modern-hobbyist/drone-controller/Schematic_drone-controller_2022-11-30.pdf

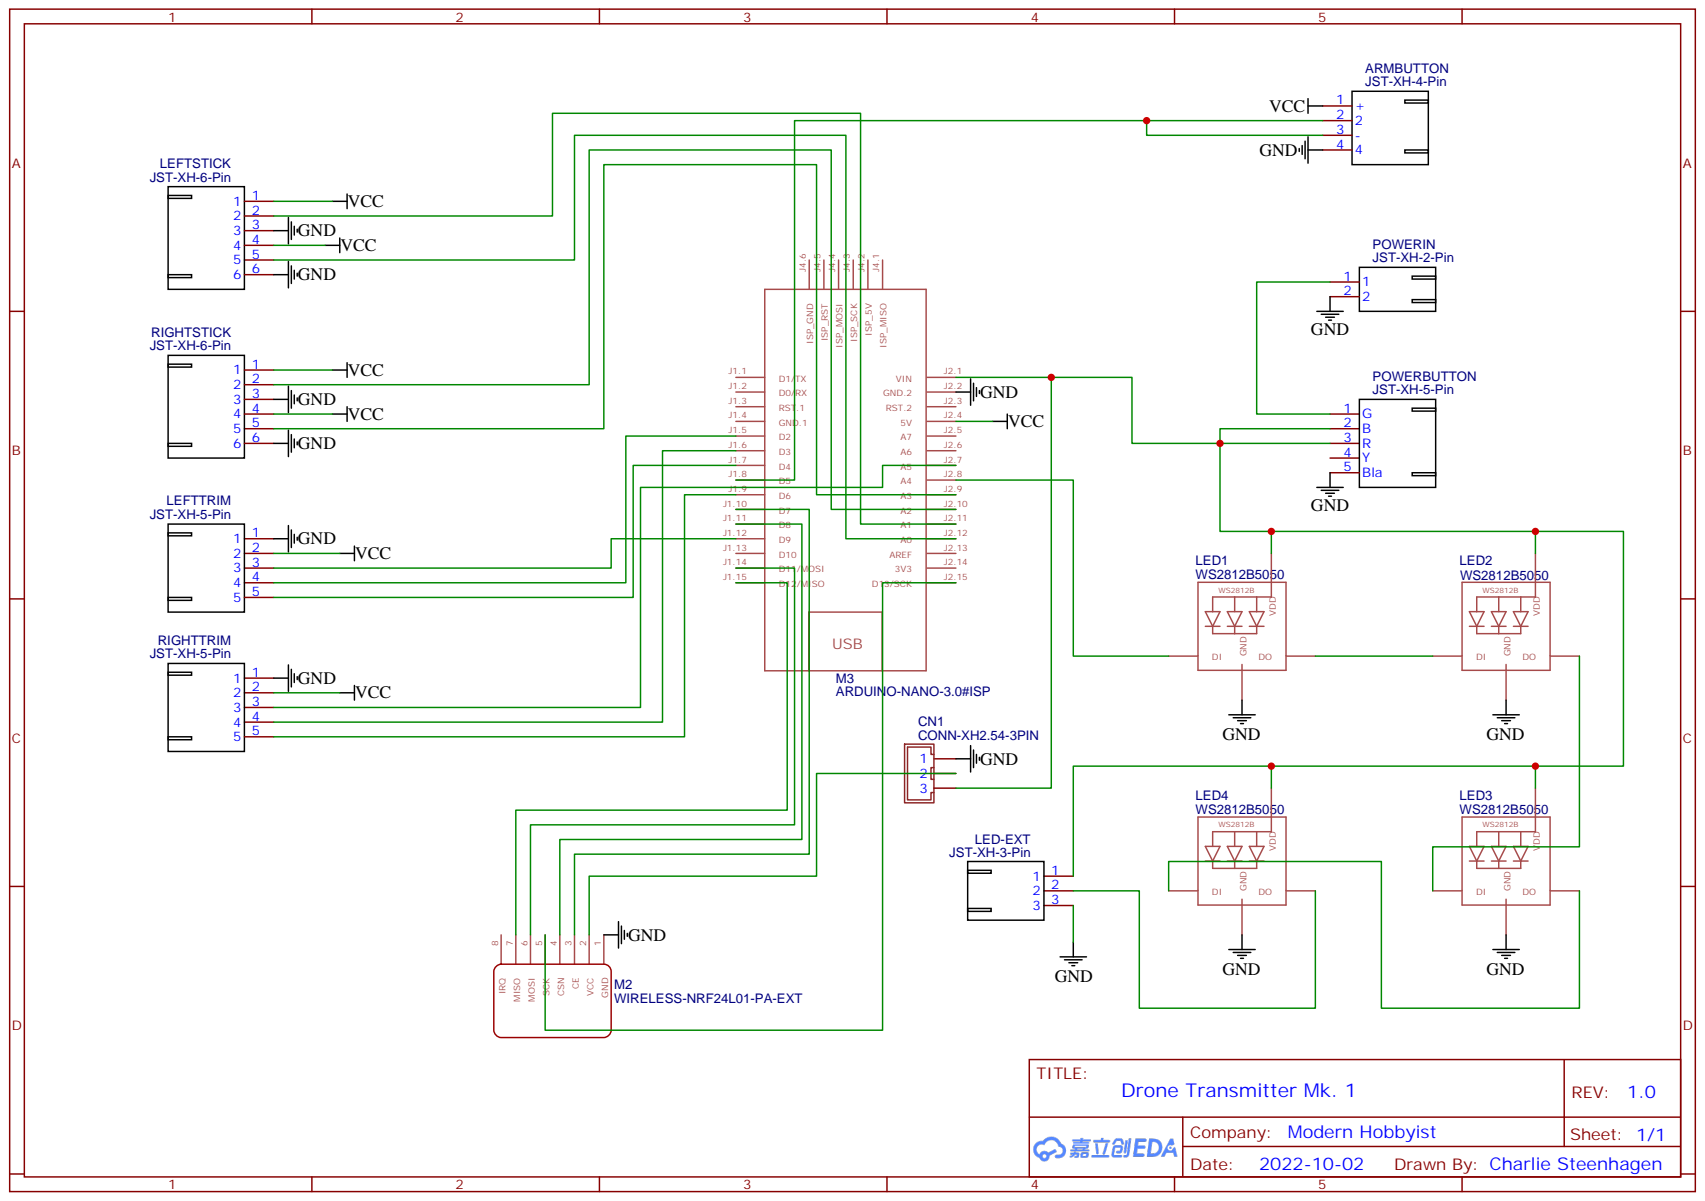
[picture p1: page 1]

Drawn By: Charlie Steenhagen
