modern-hobbyist/drone-controller/receiver/receiver.ino

#include <SPI.h>
#include <nRF24L01.h>
#include <RF24.h>

/*
 * PPM generator originally written by David Hasko
 * on https://code.google.com/p/generate-ppm-signal/ 
 */

//////////////////////CONFIGURATION///////////////////////////////
#define CHANNEL_NUMBER 6  //set the number of chanels
#define CHANNEL_DEFAULT_VALUE 1500  //set the default servo value
#define FRAME_LENGTH 22500  //set the PPM frame length in microseconds (1ms = 1000µs)
#define PULSE_LENGTH 300  //set the pulse length
#define onState 1  //set polarity of the pulses: 1 is positive, 0 is negative
#define sigPin 2  //set PPM signal output pin on the arduino

const byte address[6] = "00001";

RF24 radio(7, 8);

/*this array holds the servo values for the ppm signal
 change theese values in your code (usually servo values move between 1000 and 2000)*/
int ppm[CHANNEL_NUMBER];

// The sizeof this struct should not exceed 32 bytes
struct MyData {
  byte throttle;
  byte yaw;
  byte pitch;
  byte roll;
  byte AUX1;
  byte AUX2;
};

MyData data;
bool sendData = false;

void resetData() 
{
  // 'safe' values to use when no radio input is detected
  data.throttle = 0;
  data.yaw = 127;
  data.pitch = 127;
  data.roll = 127;
  data.AUX1 = 1;
  data.AUX2= 1;
  
  setPPMValuesFromData();
}

void setPPMValuesFromData()
{
  ppm[0] = map(data.roll,     0, 255, 1000, 2000);
  ppm[1] = map(data.pitch,    0, 255, 1000, 2000);
  ppm[2] = map(data.throttle, 0, 255, 1000, 2000);
  ppm[3] = map(data.yaw,      0, 255, 1000, 2000);
  ppm[4] = map(data.AUX1,     0, 1, 1000, 2000);
  ppm[5] = map(data.AUX2,     0, 1, 1000, 2000);  
  }

/**************************************************/

void setupPPM() {
  pinMode(sigPin, OUTPUT);
  digitalWrite(sigPin, 0);  //set the PPM signal pin to the default state (off)

  cli();
  TCCR1A = 0; // set entire TCCR1 register to 0
  TCCR1B = 0;

  OCR1A = 100;  // compare match register (not very important, sets the timeout for the first interrupt)
  TCCR1B |= (1 << WGM12);  // turn on CTC mode
  TCCR1B |= (1 << CS11);  // 8 prescaler: 0,5 microseconds at 16mhz
  TIMSK1 |= (1 << OCIE1A); // enable timer compare interrupt
  sei();
}

void setup(){  
  Serial.begin(115200);

  resetData();
  setupPPM();
  
  // Set up radio module
  radio.begin();
  radio.openReadingPipe(0, address);
  radio.setPALevel(RF24_PA_MIN);
  radio.startListening();
  
  //initiallize default ppm values
  for(int i=0; i<CHANNEL_NUMBER; i++){
      ppm[i]= CHANNEL_DEFAULT_VALUE;
  }

  pinMode(sigPin, OUTPUT);
  digitalWrite(sigPin, !onState);  //set the PPM signal pin to the default state (off)
  
  cli();
  TCCR1A = 0; // set entire TCCR1 register to 0
  TCCR1B = 0;
  
  OCR1A = 100;  // compare match register, change this
  TCCR1B |= (1 << WGM12);  // turn on CTC mode
  TCCR1B |= (1 << CS11);  // 8 prescaler: 0,5 microseconds at 16mhz
  TIMSK1 |= (1 << OCIE1A); // enable timer compare interrupt
  sei();

}

/**************************************************/

unsigned long lastRecvTime = 0;

void recvData()
{  
  while ( radio.available() ) {        
    radio.read(&data, sizeof(MyData));
    lastRecvTime = millis();
    sendData = true;
  }
}

/**************************************************/

void loop(){
  
  recvData();

  unsigned long now = millis();
  if ( now - lastRecvTime > 1000 ) {
    // signal lost?
    resetData();
    sendData = false;
  }
  
  setPPMValuesFromData();
  printValues();
  
}

void printValues(){
  // for(int i = 0; i < CHANNEL_NUMBER; i++){
  //   Serial.print(ppm[i]);
  //   Serial.print(" - ");  
  // }
  // Serial.println();
  // Serial.println(ppm[2]);
}

ISR(TIMER1_COMPA_vect){  //leave this alone
  static boolean state = true;
  
  TCNT1 = 0;
  if(sendData){
    if (state) {  //start pulse
      digitalWrite(sigPin, onState);
      OCR1A = PULSE_LENGTH * 2;
      state = false;
    } else{  //end pulse and calculate when to start the next pulse
      static byte cur_chan_numb;
      static unsigned int calc_rest;
    
      digitalWrite(sigPin, !onState);
      state = true;

      if(cur_chan_numb >= CHANNEL_NUMBER){
        cur_chan_numb = 0;
        calc_rest = calc_rest + PULSE_LENGTH;// 
        OCR1A = (FRAME_LENGTH - calc_rest) * 2;
        calc_rest = 0;
      }
      else{
        OCR1A = (ppm[cur_chan_numb] - PULSE_LENGTH) * 2;
        calc_rest = calc_rest + ppm[cur_chan_numb];
        cur_chan_numb++;
      }     
    }
  }
}
