modern-hobbyist/drone-controller/(commit log)

2022-10-04 Added check for pot button click
2022-10-05 Changed right trim pin, pin 10 was causing voltage drop
2022-10-17 Updated all the outputs to be oriented correctly
    [transmitter.ino]
2022-10-17 Was able to spin the right gimbal back to the correct position
    [transmitter.ino]
